yecreate/4-bit-alu-discrete/schematics/Block_Diagram.png

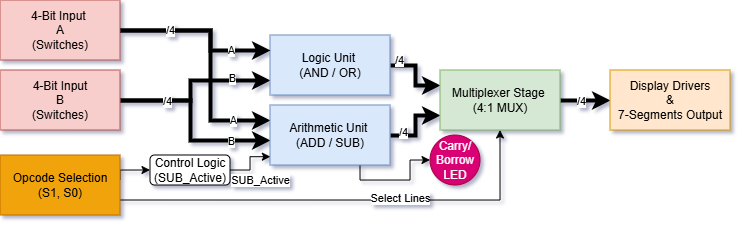
schematics/Block_Diagram.png
