yecreate/4-bit-alu-discrete/(list of files, drawings)

Other design files:
circuits/ALU_Main.circ
circuits/Discrete_Mux.circ
